phillipdavidstearns/angela-nguyen-conveyor/(list of files, cad)

Other CAD files:
Renders/conveyors.blend
