phillipdavidstearns/angela-nguyen-conveyor/resources/images/wiring-diagram.jpg

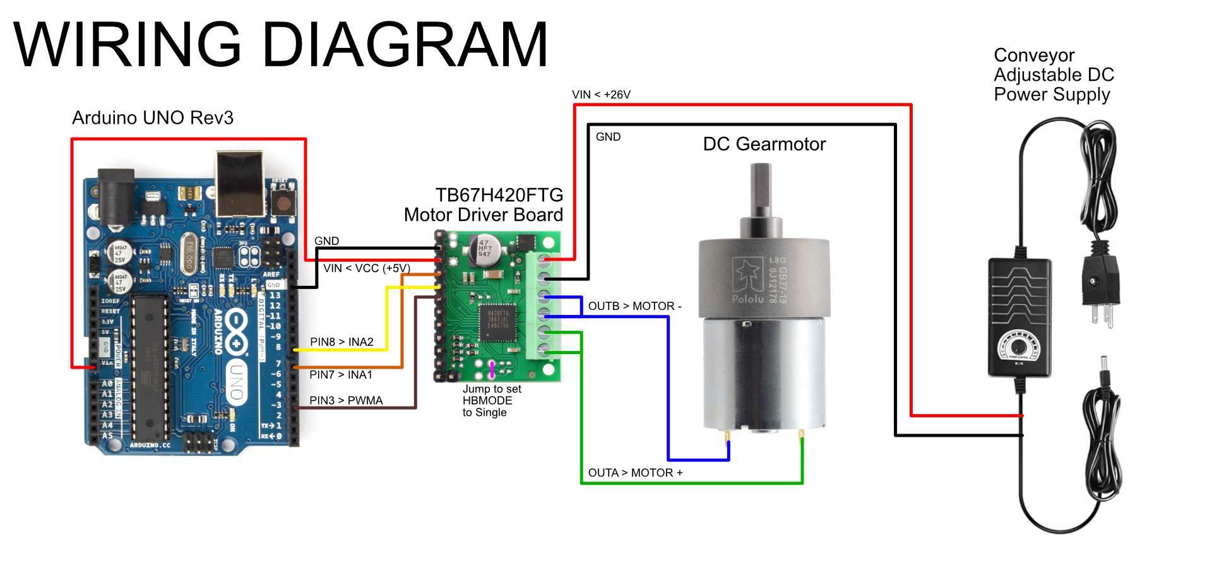
resources/images/wiring-diagram.jpg
