phillipdavidstearns/angela-nguyen-conveyor/(commit log)

2025-05-27 refining motion and direction logic to removed unexpected erratic behavior when reversing direction
    [controller_test.ino]
2025-09-27 ported code over to Arduino Mega
    [conveyors.blend]
2025-10-02 documentation, guide, comments
    [conveyors.blend]
